HMSteve/HB-UNI-Sen-PM/images/pcb_main.jpg

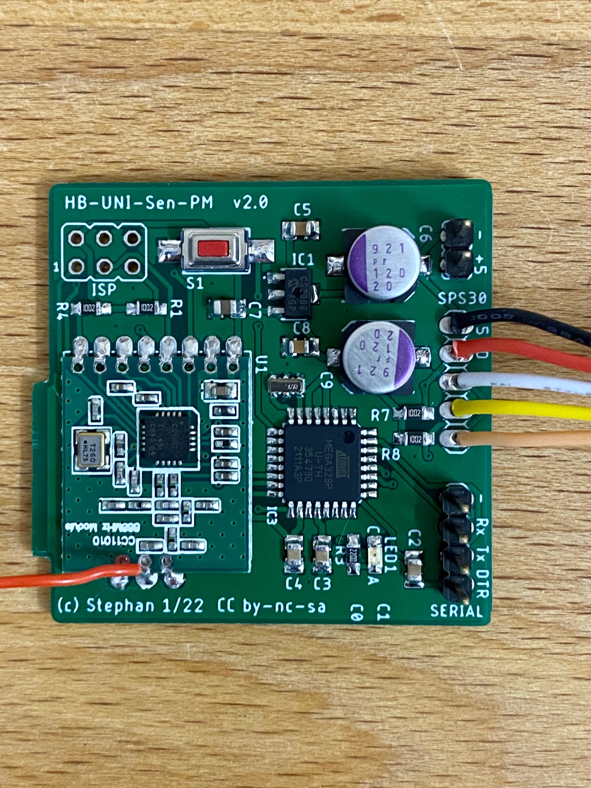
images/pcb_main.jpg
