HMSteve/HB-UNI-Sen-PM/images/pcb_both.jpg

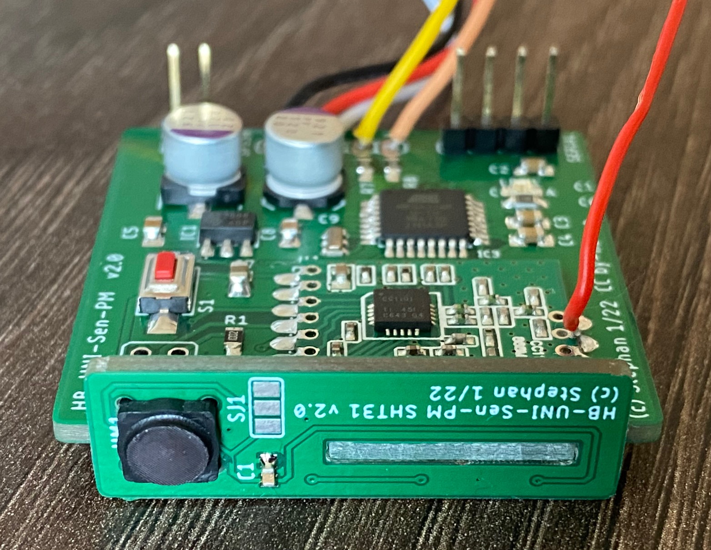
images/pcb_both.jpg
