HMSteve/HB-UNI-Sen-PM/images/deckel.JPG

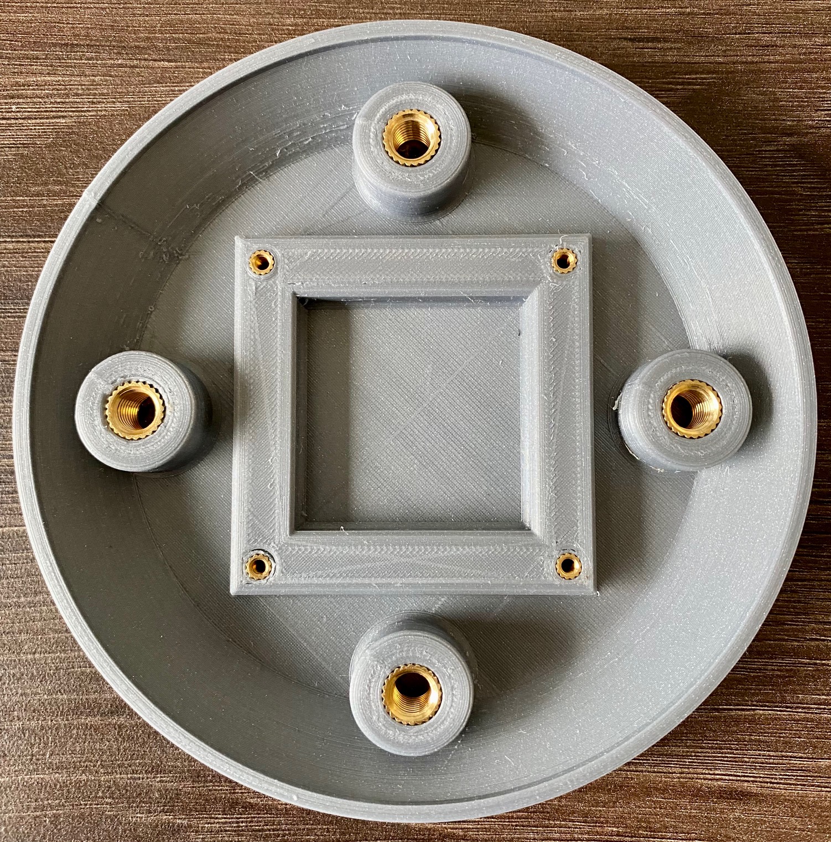
images/deckel.JPG
