HMSteve/HB-UNI-Sen-PM/images/deckel_und_innengehaeuse.jpg

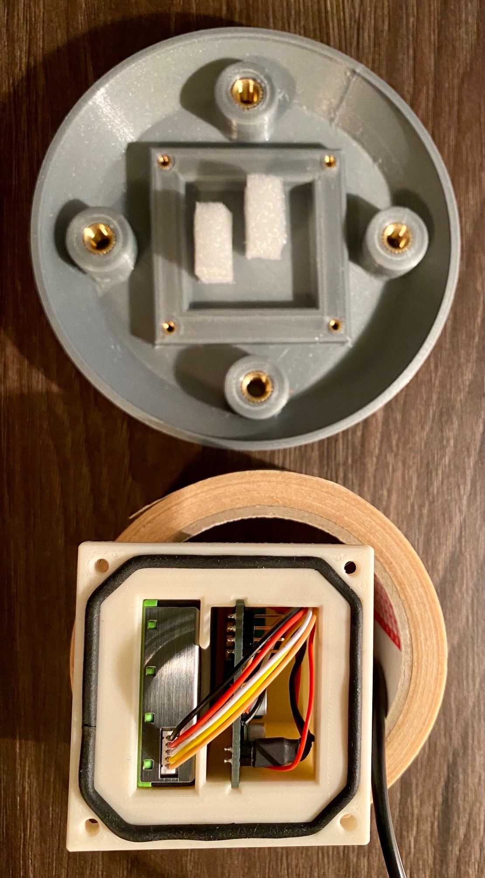
images/deckel_und_innengehaeuse.jpg
