HMSteve/HB-UNI-Sen-PM/images/innengehaeuse_montiert.JPG

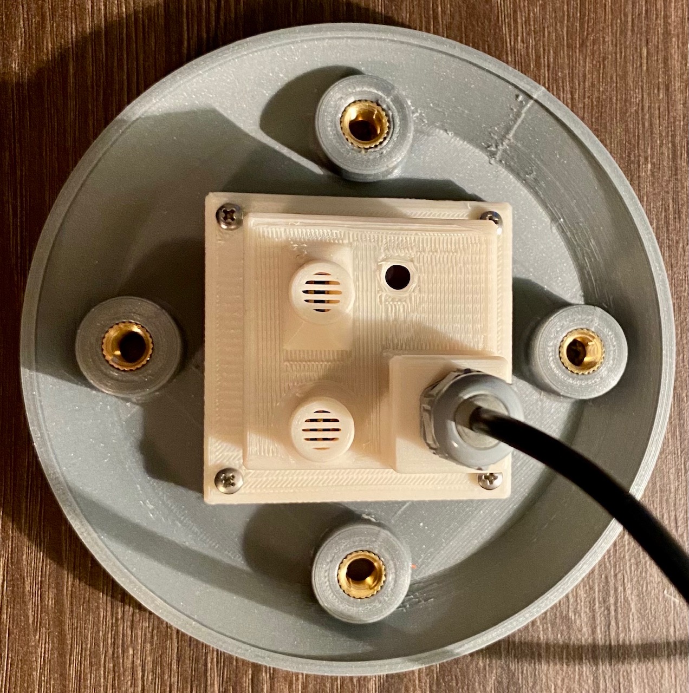
images/innengehaeuse_montiert.JPG
