HMSteve/HB-UNI-Sen-PM/images/komplett_seite.JPG

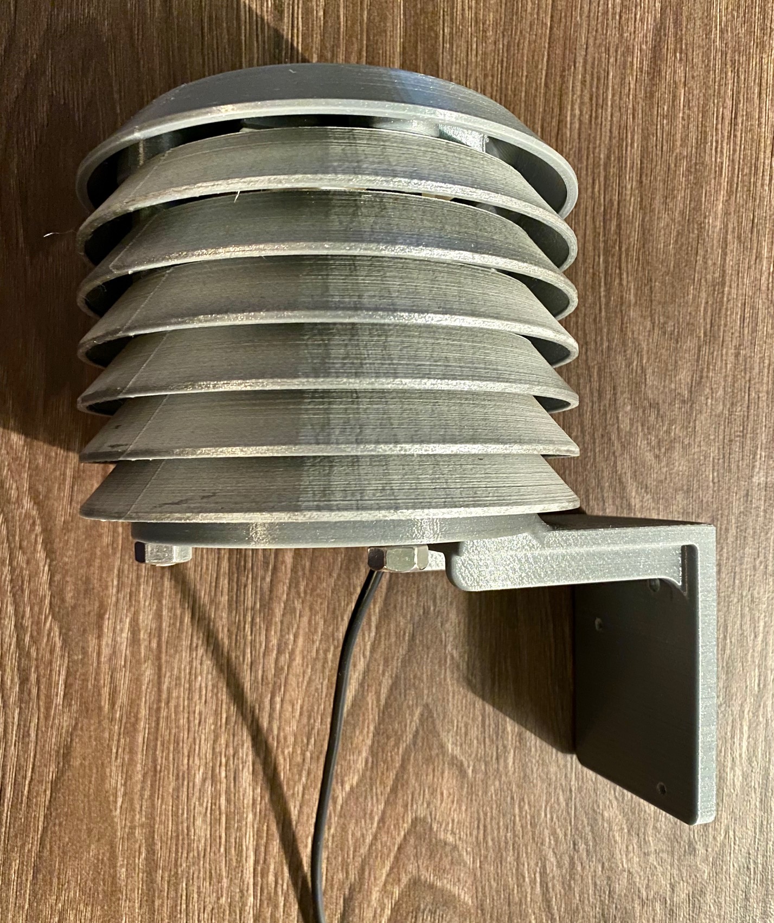
images/komplett_seite.JPG
