HMSteve/HB-UNI-Sen-PM/images/komplett_unten.JPG

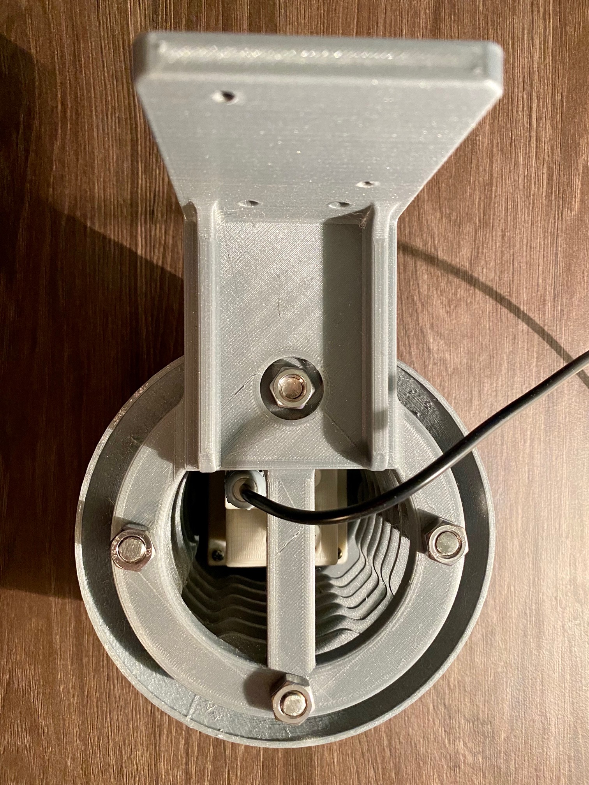
images/komplett_unten.JPG
