HMSteve/HB-UNI-Sen-PM/images/pcb_and_sps.jpg

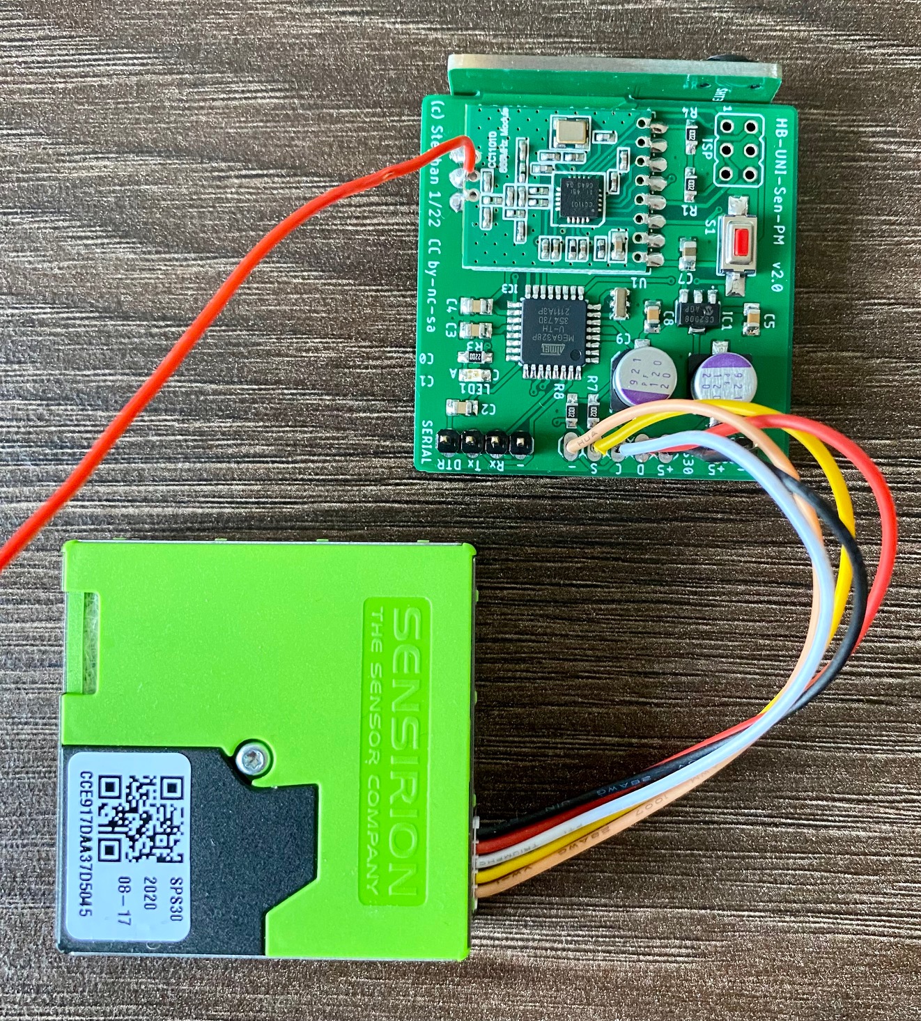
images/pcb_and_sps.jpg
