HMSteve/HB-UNI-Sen-PM/images/webui_config.jpg

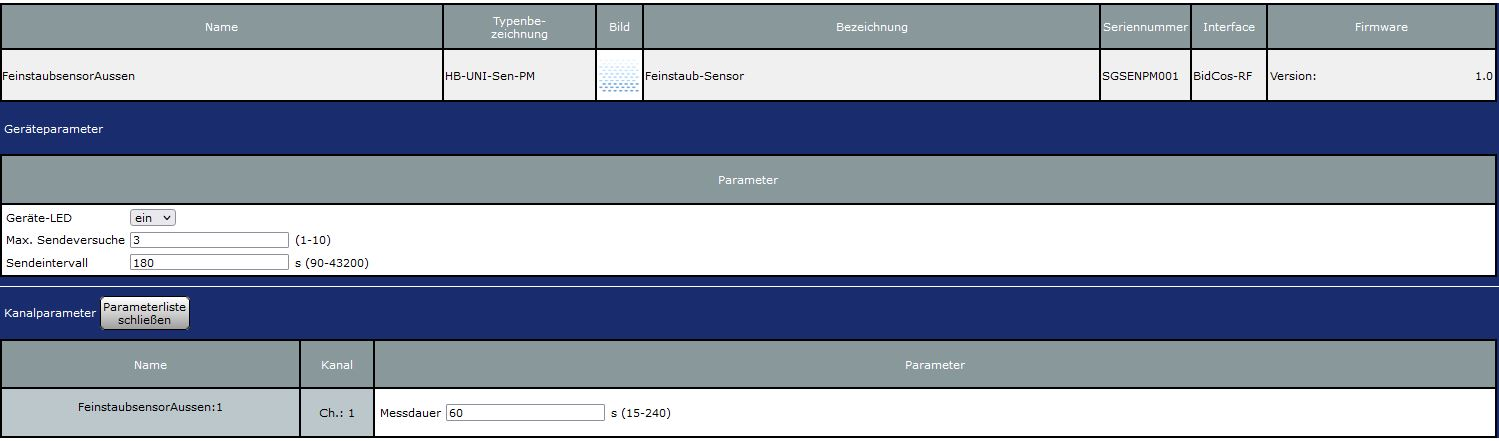
images/webui_config.jpg
