HMSteve/HB-UNI-Sen-PM/images/webui_status.jpg

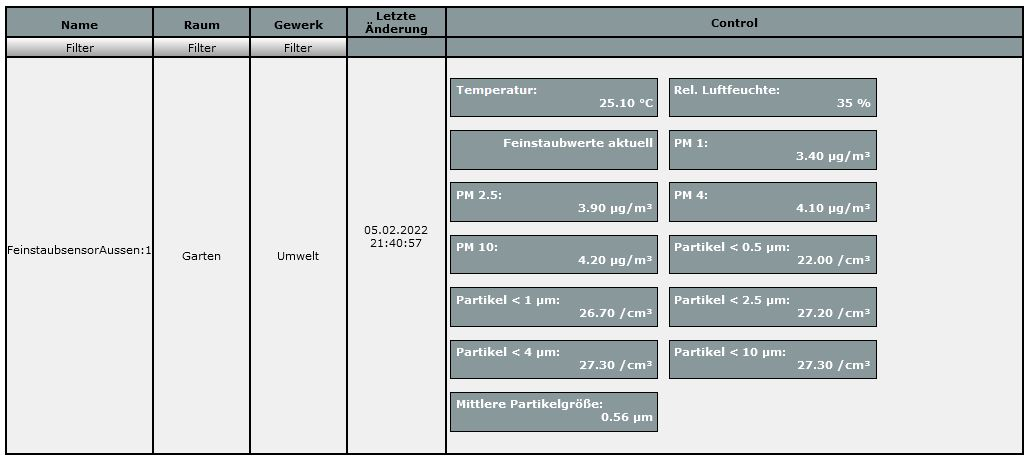
images/webui_status.jpg
