HMSteve/HB-UNI-Sen-PM/3D_Druck/LuftSchlauch.stl

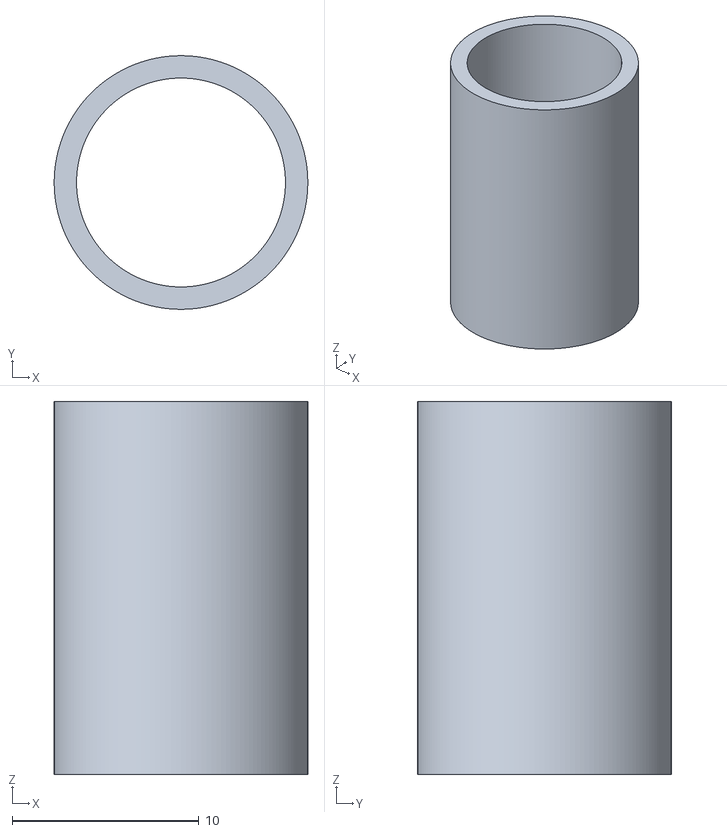
[picture p11: CAD file, 2022-02-05]
3D_Druck/LuftSchlauch.stl
13.6 x 13.6 x 20.0
