HMSteve/HB-UNI-Sen-PM/3D_Druck/SPS30Halter.stl

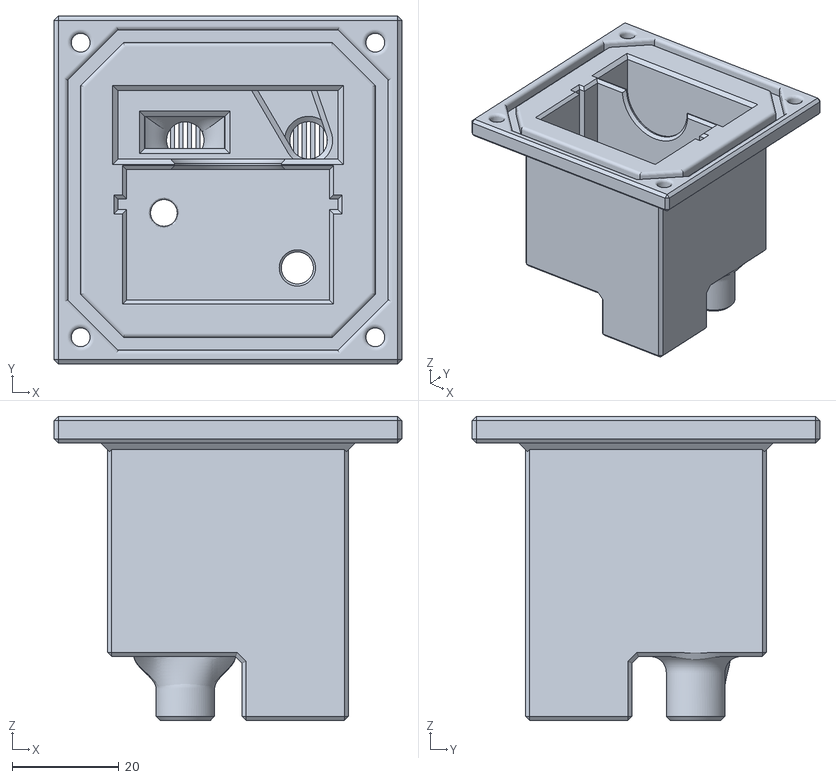
[picture p12: CAD file, 2022-02-05]
3D_Druck/SPS30Halter.stl
65.2 x 65.2 x 57.0
