HMSteve/HB-UNI-Sen-PM/3D_Druck/StevenssonScreenWandhalterBasis.stl

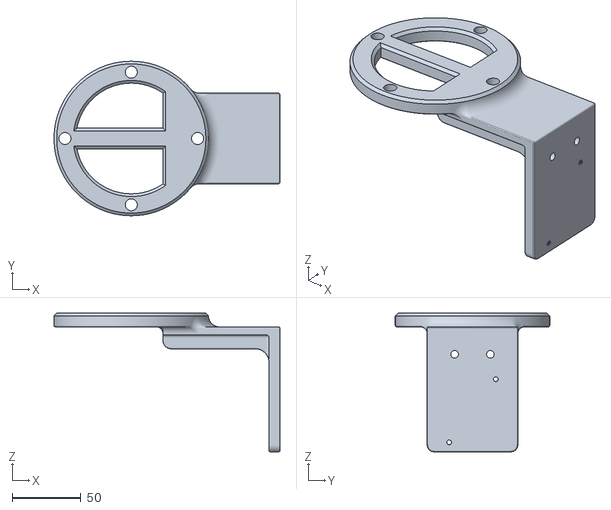
[picture p13: CAD file, 2022-02-05]
3D_Druck/StevenssonScreenWandhalterBasis.stl
164.5 x 112.5 x 101.0
