HMSteve/HB-UNI-Sen-PM/3D_Druck/middle_part_x6.STL

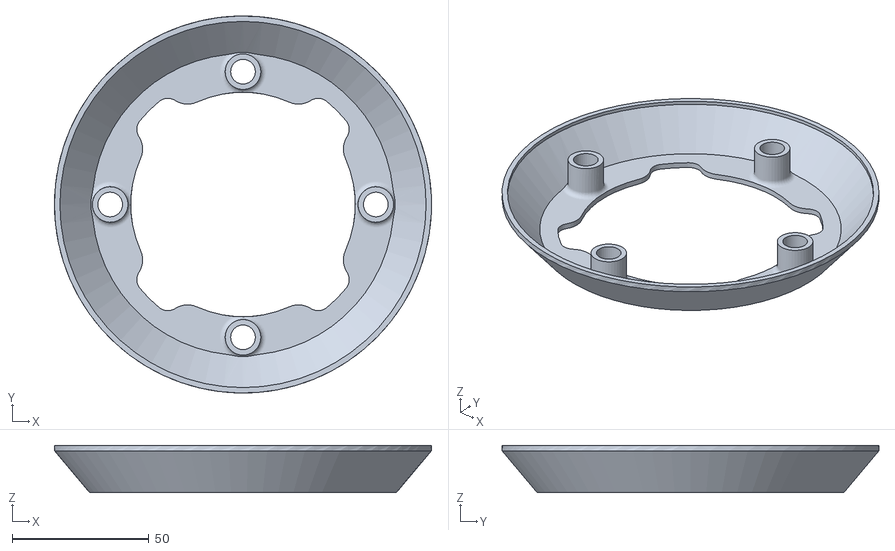
[picture p14: CAD file, 2022-02-05]
3D_Druck/middle_part_x6.STL
137.7 x 137.7 x 17.3
