HMSteve/HB-UNI-Sen-PM/3D_Druck/DeckelSPS30.stl

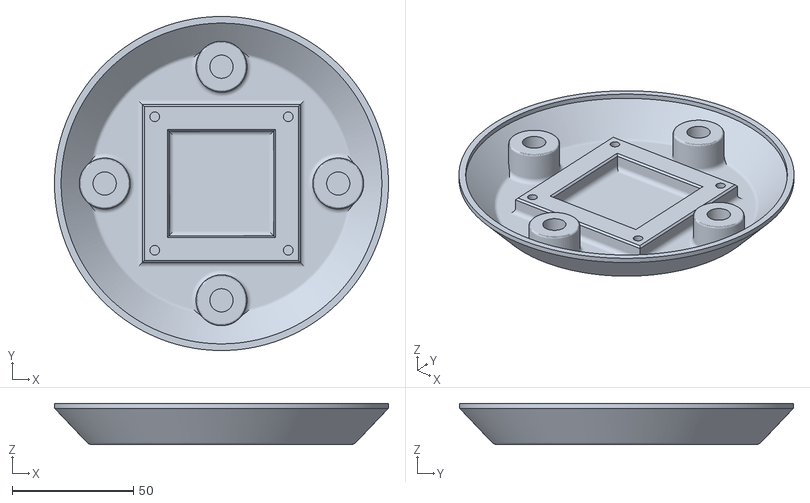
[picture p15: CAD file, 2022-02-05]
3D_Druck/DeckelSPS30.stl
138.0 x 138.0 x 17.0
