HMSteve/HB-UNI-Sen-PM/PCB/HB-UNI-Sen-PM_SHT31_v2_Schematic.pdf

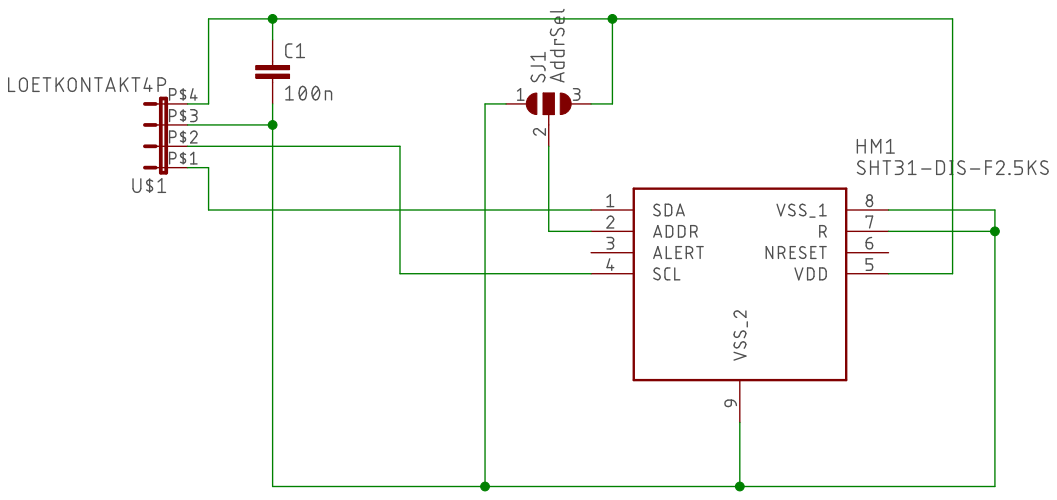
[picture p16: page 1]
