HMSteve/HB-UNI-Sen-PM/PCB/HB-UNI-Sen-PM_v2_Schematic.pdf

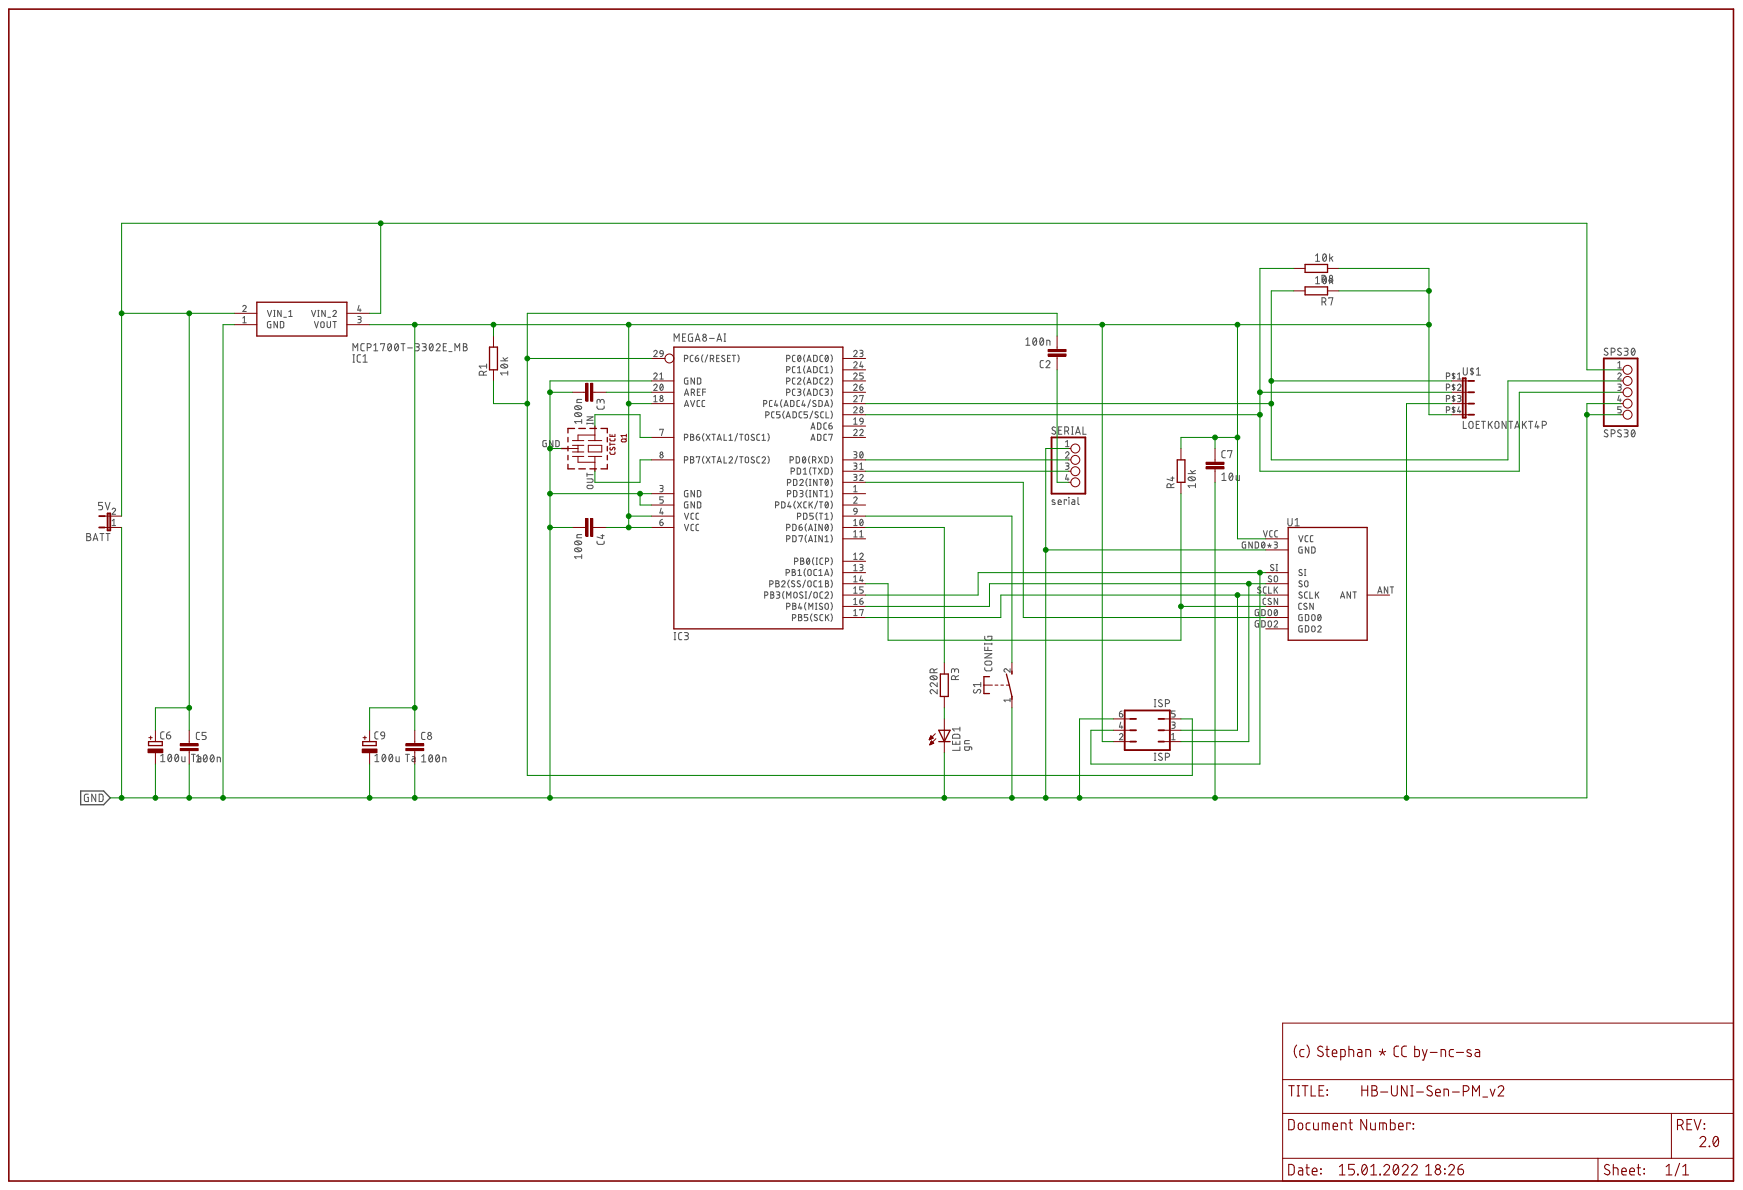
[picture p17: page 1]
