HMSteve/HB-UNI-Sen-PM/PCB/HB-UNI-Sen-PM_SHT31_v2_BottomPlace.pdf

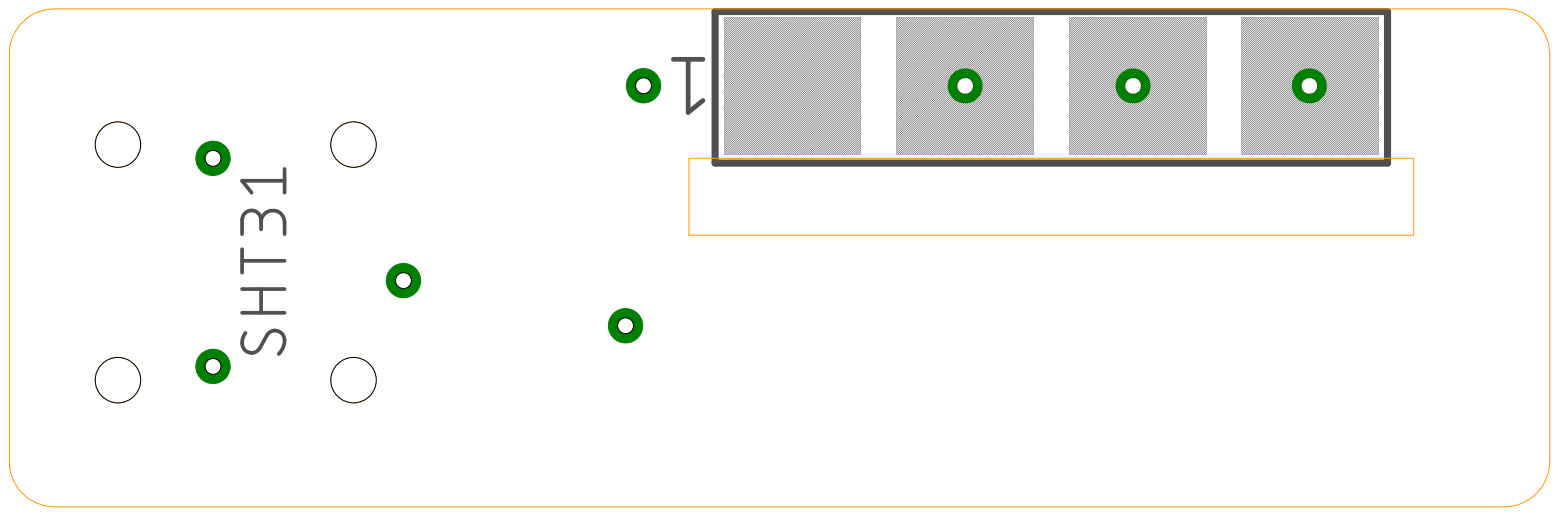
[picture p18: page 1]
