HMSteve/HB-UNI-Sen-PM/PCB/HB-UNI-Sen-PM_SHT31_v2_TopPlace.pdf

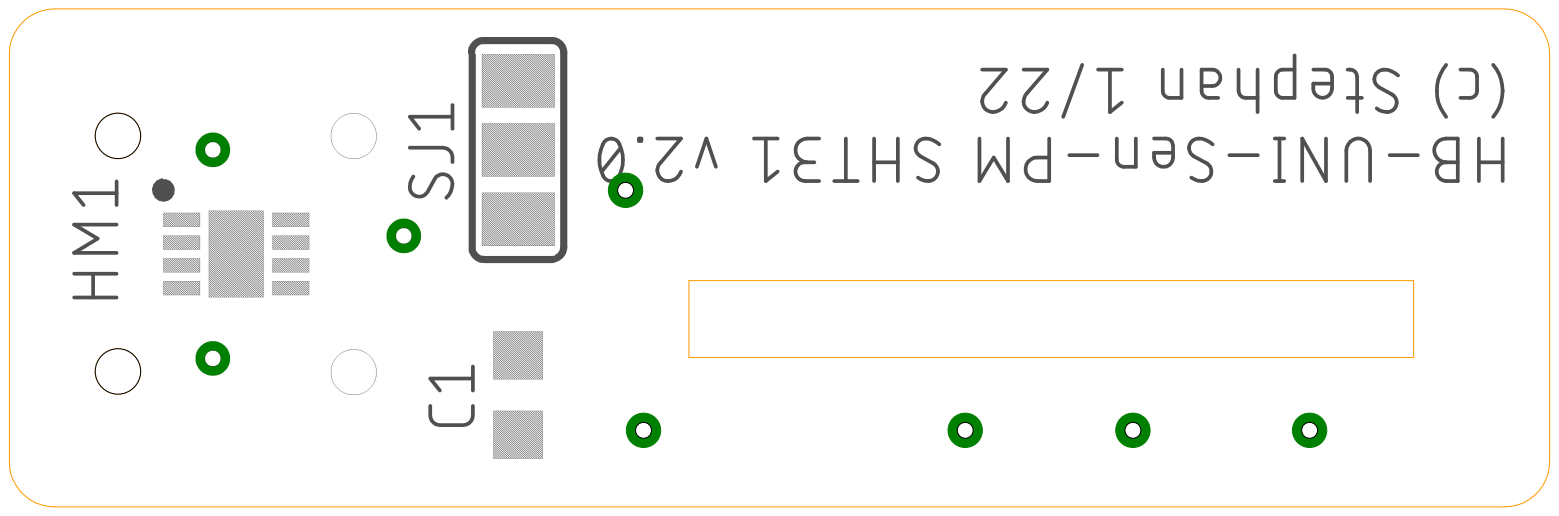
[picture p19: page 1]
