HMSteve/HB-UNI-Sen-PM/PCB/HB-UNI-Sen-PM_v2_BottomPlace.pdf

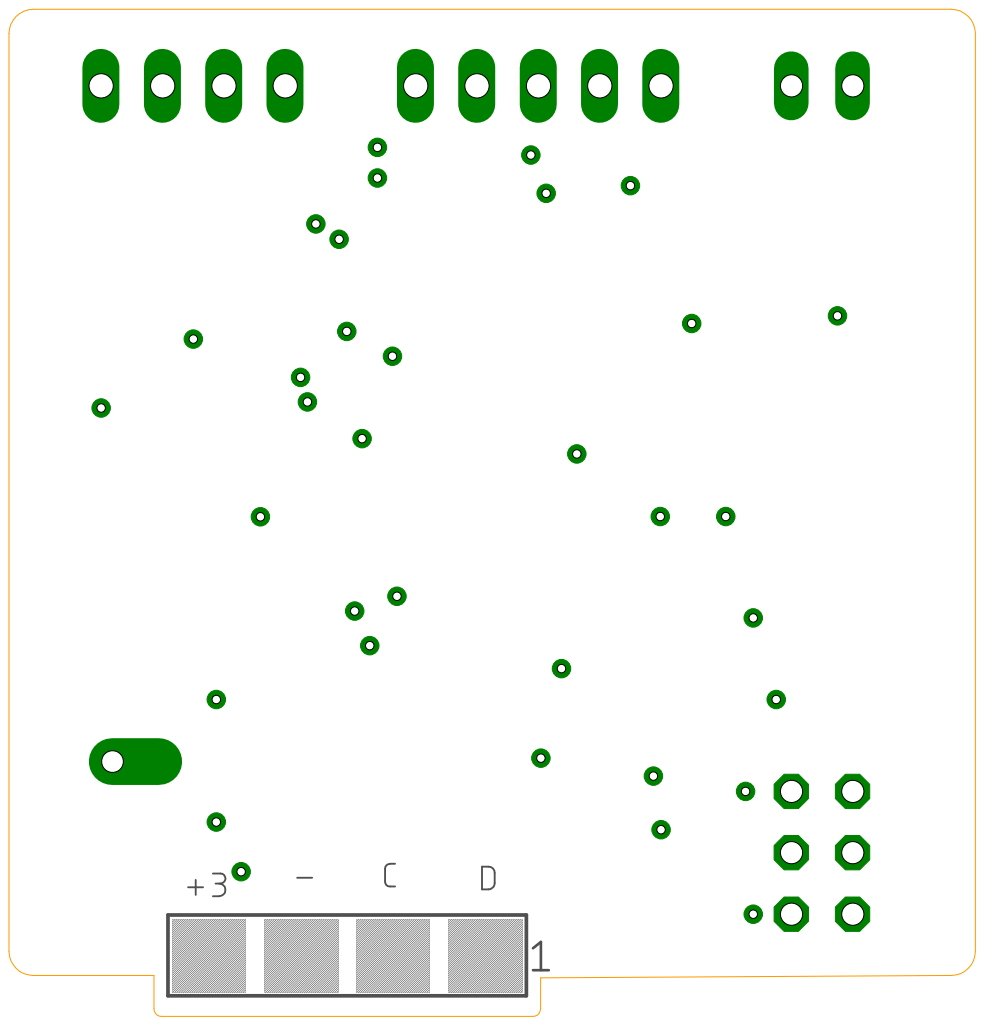
[picture p20: page 1]
