HMSteve/HB-UNI-Sen-PM/PCB/HB-UNI-Sen-PM_v2_TopPlace.pdf

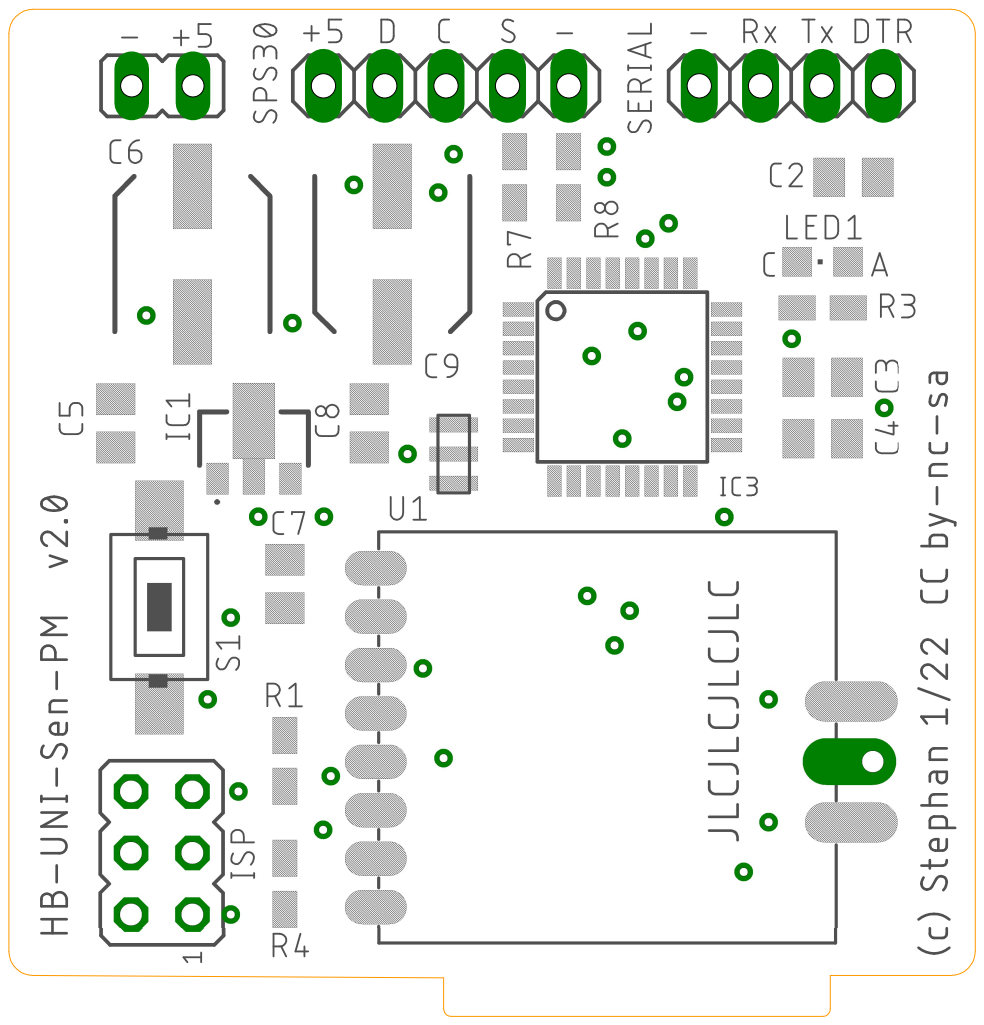
[picture p21: page 1]
