HMSteve/HB-UNI-Sen-PM/PCB/HB-UNI-Sen-PM_v2p1.brd

## EAGLE design PCB/HB-UNI-Sen-PM_v2p1.brd (2022-01-27)

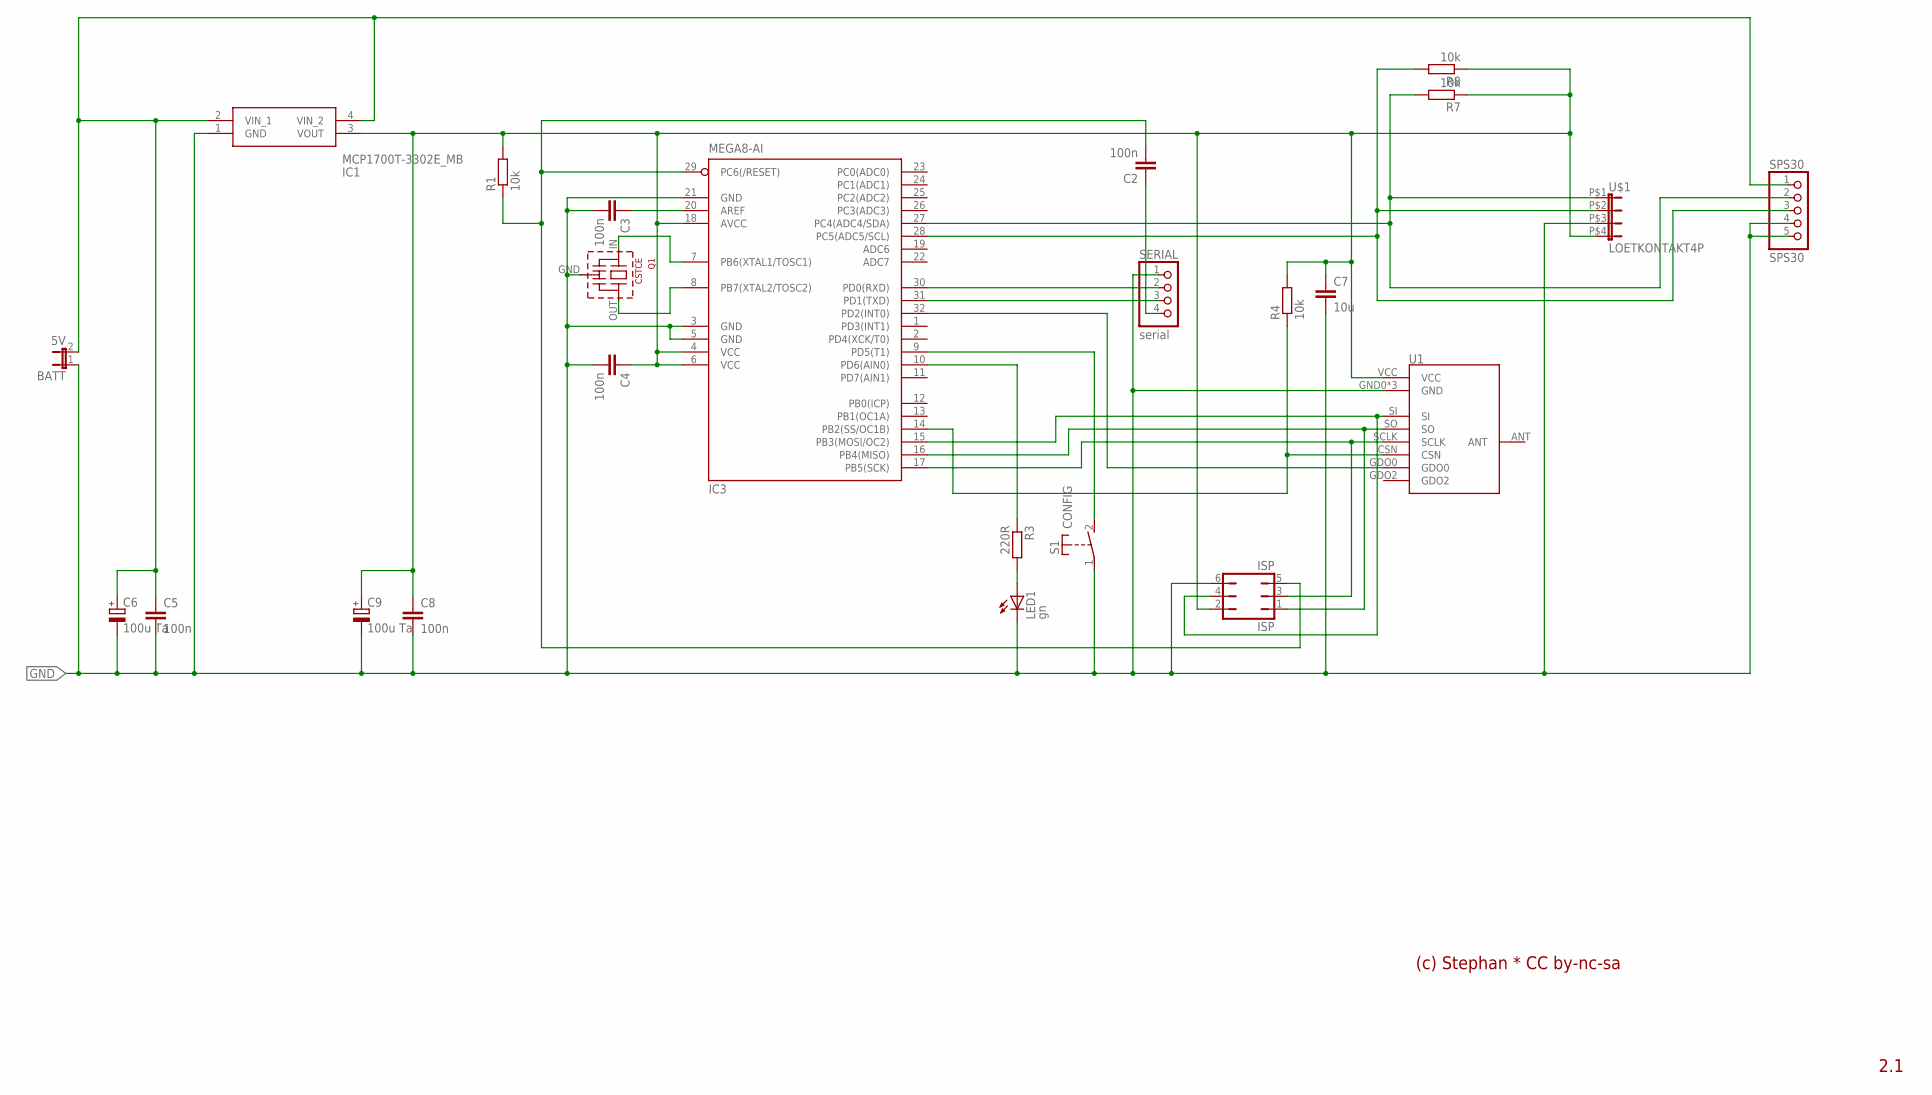
[picture p22: schematic HB-UNI-Sen-PM_v2p1.sch]

Parts:
BATT: 5V; JP1
C2, C3, C4, C5, C8: 100n; C0805K
C6, C9: 100u Ta; SANYO-OSCON_SMD_C6
C7: 10u; C0805K
IC1: MCP1700T-3302E_MB; MCP1700T-3302E/MB
IC3: MEGA8-AI; TQFP32-08
ISP: ISP; JP3Q
LED1: gn; CHIPLED_0805
Q1: CSTCE
R1, R4, R7, R8: 10k; R0805W
R3: 220R; R0805W
S1: CONFIG; SMDSWITCH6X4
SERIAL: serial; 1X04
SPS30: SPS30; 1X05
U1: CC1101SMD; CC1101-SMD
U$1: LOETKONTAKT4P

Connections:
3V3: C4.1, C7.1, C8.1, C9.+, IC1.3 (VOUT), IC3.4 (VCC), IC3.6 (VCC), IC3.18 (AVCC), ISP.2, R1.2, R4.2, R7.1, R8.1, U1.VCC, U$1.P$4 (4)
5V: BATT.2, C5.1, C6.+, IC1.2 (VIN_1), IC1.4 (VIN_2), SPS30.1
AREF: C3.1, IC3.20 (AREF)
CSN: IC3.14 (PB2(SS/OC1B)), R4.1, U1.CSN
DTR: C2.1, SERIAL.4
GDO0: IC3.32 (PD2(INT0)), U1.GDO0
GND: BATT.1, C3.2, C4.2, C5.2, C6.-, C7.2, C8.2, C9.-, IC1.1 (GND), IC3.3 (GND), IC3.5 (GND), IC3.21 (GND), ISP.6, LED1.C, Q1.GND, S1.1, SERIAL.1, SPS30.4, SPS30.5, U1.GND0 (GND), U1.GND1 (GND), U1.GND2 (GND), U$1.P$3 (3)
LED1: LED1.A, R3.2
MISO: IC3.16 (PB4(MISO)), ISP.1, U1.SO
MOSI: IC3.15 (PB3(MOSI/OC2)), ISP.4, U1.SI
PD5: IC3.9 (PD5(T1)), S1.2 (S)
PD6: IC3.10 (PD6(AIN0)), R3.1
RESET: C2.2, IC3.29 (PC6(/RESET)), ISP.5, R1.1
RXD: IC3.30 (PD0(RXD)), SERIAL.2
SCL: IC3.28 (PC5(ADC5/SCL)), R8.2, SPS30.3, U$1.P$2 (2)
SCLK: IC3.17 (PB5(SCK)), ISP.3, U1.SCLK
SDA: IC3.27 (PC4(ADC4/SDA)), R7.2, SPS30.2, U$1.P$1 (1)
TXD: IC3.31 (PD1(TXD)), SERIAL.3
XTAL1: IC3.7 (PB6(XTAL1/TOSC1)), Q1.IN
XTAL2: IC3.8 (PB7(XTAL2/TOSC2)), Q1.OUT

Notes on the sheet:
2.1
(c) Stephan * CC by-nc-sa

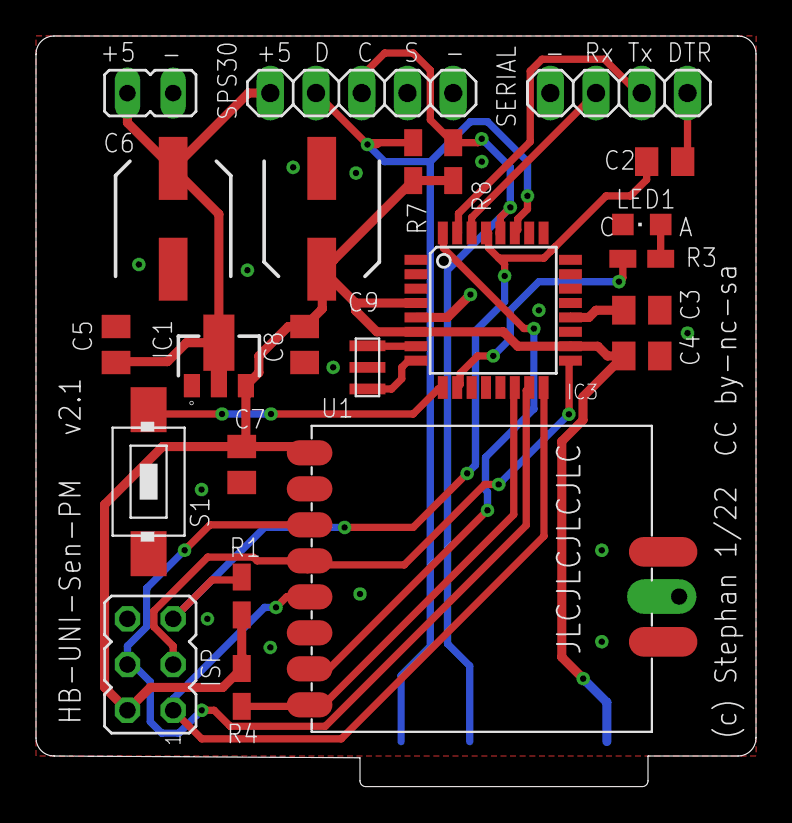
[picture p23: board HB-UNI-Sen-PM_v2p1.brd from above]

Board: 2 copper layers, 40.0 x 41.7 mm, 24 parts (1 on the bottom side), 20 nets.
