HMSteve/HB-UNI-Sen-PM/PCB/HB-UNI-Sen-PM_SHT31_Board_v2.brd

## EAGLE design PCB/HB-UNI-Sen-PM_SHT31_Board_v2.brd (2022-01-27)

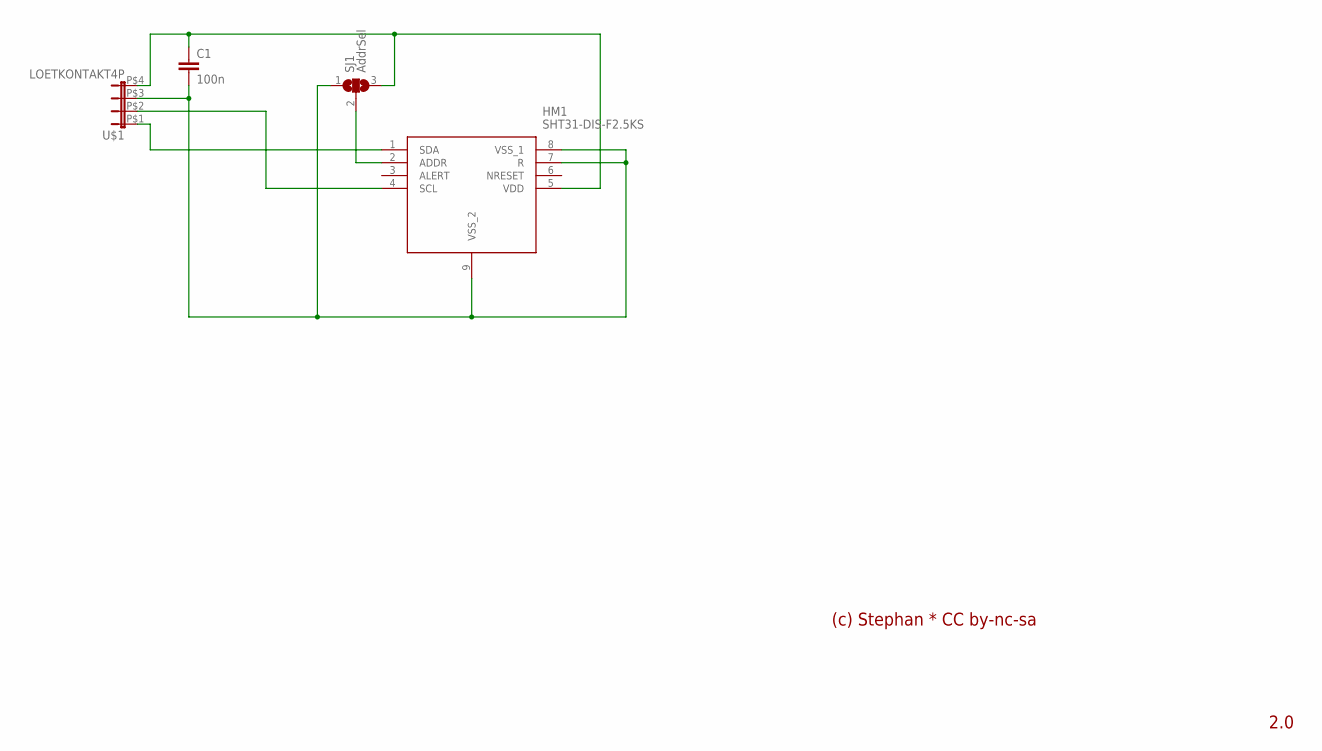
[picture p24: schematic HB-UNI-Sen-PM_SHT31_Board_v2.sch]

Parts:
C1: 100n; C0603K
HM1: SHT31-DIS-F2.5KS; SON50P250X250X90-9N
SJ1: AddrSel; SJ_2
U$1: LOETKONTAKT4P

Connections:
3V3: C1.1, HM1.5 (VDD), SJ1.3, U$1.P$4 (4)
ADDR: HM1.2 (ADDR), SJ1.2
GND: C1.2, HM1.7 (R), HM1.8 (VSS_1), HM1.9 (VSS_2), SJ1.1, U$1.P$3 (3)
SCL: HM1.4 (SCL), U$1.P$2 (2)
SDA: HM1.1 (SDA), U$1.P$1 (1)

Notes on the sheet:
(c) Stephan * CC by-nc-sa
2.0

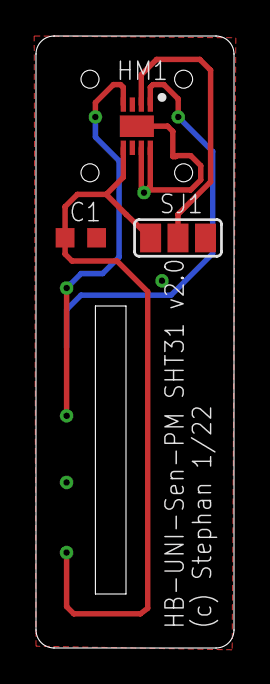
[picture p25: board HB-UNI-Sen-PM_SHT31_Board_v2.brd from above]

Board: 2 copper layers, 11.0 x 34.0 mm, 4 parts (1 on the bottom side), 5 nets.
