HMSteve/HB-UNI-Sen-PM/(commit log)

2021-12-29 pcb added
    [HB-UNI-Sen-PM_v1.brd, HB-UNI-Sen-PM_v1.sch]
2022-01-27 pcb silkscreen corrected in v2.1, first working version of software
    [HB-UNI-Sen-PM_SHT31_Board_v2.brd, HB-UNI-Sen-PM_SHT31_Board_v2.sch, HB-UNI-Sen-PM_v1.brd, HB-UNI-Sen-PM_v2.brd, HB-UNI-Sen-PM_v2.sch, HB-UNI-Sen-PM_v2p1.brd, HB-UNI-Sen-PM_v2p1.sch]
2022-01-30 humindity threshold and fan cleaning added
2022-02-04 fan cleaning and sampling period added
2022-02-05 stls added
    [DeckelSPS30.stl, LuftSchlauch.stl, SPS30Halter.stl, StevenssonScreenWandhalterBasis.stl, middle_part_x6.STL]
