HMSteve/HB-UNI-Sen-PM/(notices)

Notices in the files:
PCB/HB-UNI-Sen-PM_v1.brd:
(c) Stephan 6/21 CC by-nc-sa
PCB/HB-UNI-Sen-PM_v2.brd:
(c) Stephan 1/22 CC by-nc-sa
parts and their libraries:
modules: Released under the Creative Commons Attribution 4.0 International License: http://creativecommons.org/licenses/by/4.0
